praveenreddy0073/exoskeleton-controller1/IMG-20260514-WA0012.jpg

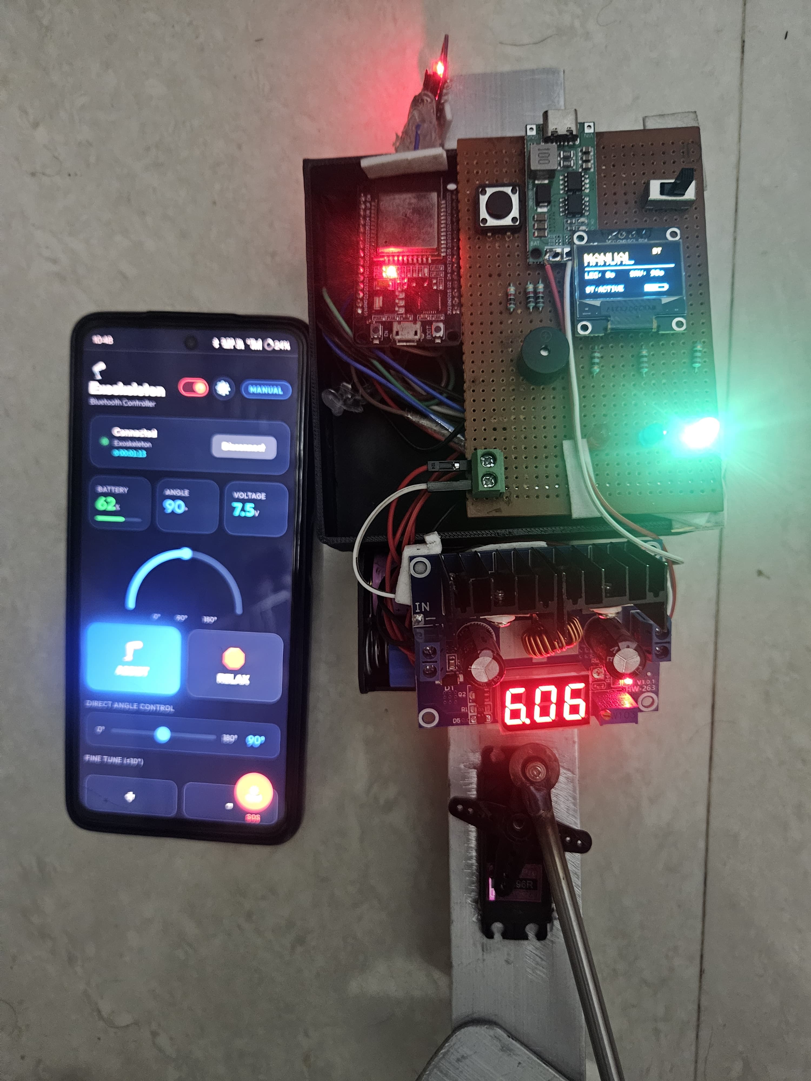
IMG-20260514-WA0012.jpg
