praveenreddy0073/exoskeleton-controller1/IMG-20260514-WA0013.jpg

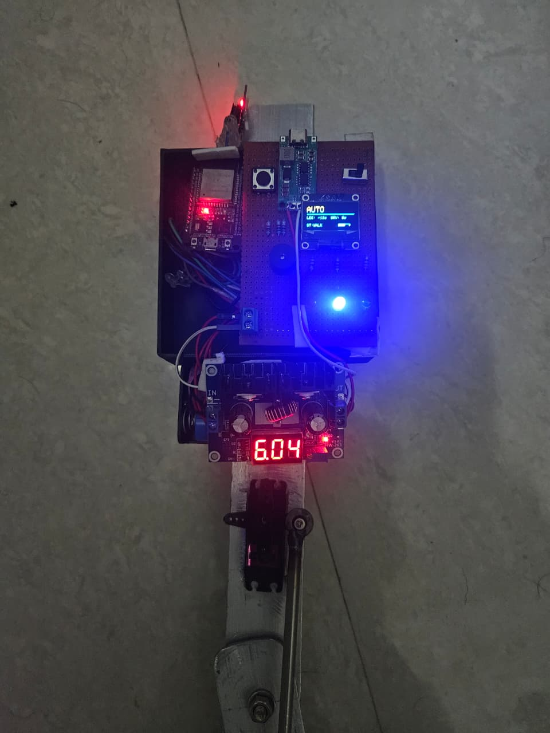
IMG-20260514-WA0013.jpg
